Stepashka369/schemota/перечень элементов часть 1.pdf

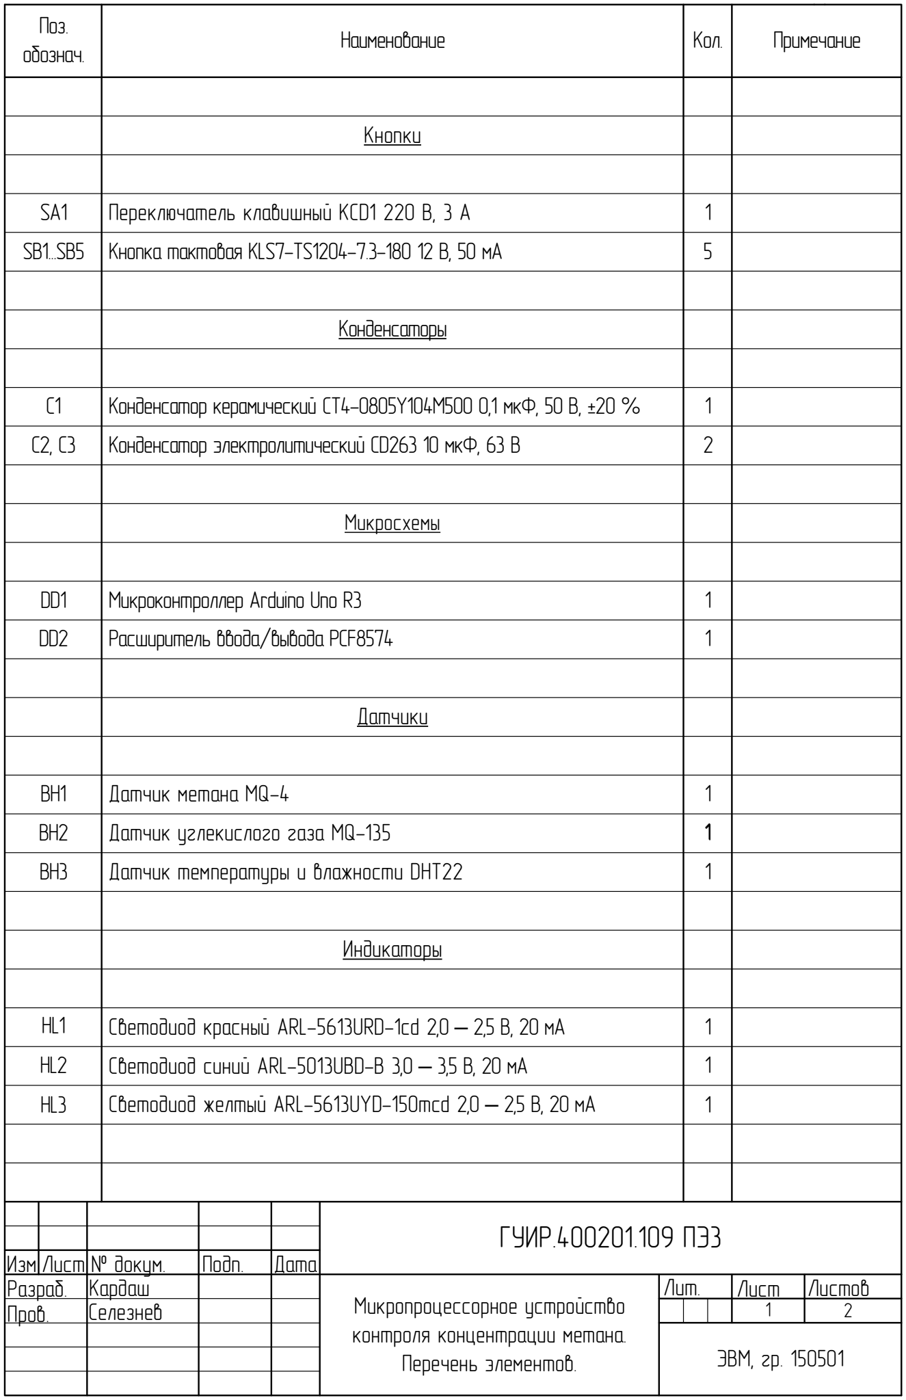
[picture p9: figure]
Изм Лист ¹ докум.; Подп.; Дата; Разраб.; Лит.; Лист; Листов; Пров.; Поз.; обознач.; Наименование; Кол.; Примечание; Микросхемы; Индикаторы; Кнопки; Конденсаторы; Переключатель клавишный KCD1 220 В, 3 А; Микроконтроллер Arduino Uno R3; Расширитель ввода/вывода PCF8574; Датчики; Датчик метана MQ-4; Датчик углекислого газа MQ-135; Датчик температуры и влажности DHT22; Кардаш Селезнев; ГУИР.400201.109 ПЭ3; ЭВМ, гр. 150501; Микропроцессорное устройство контроля концентрации метана. Перечень элементов.

Конденсатор керамический CT4-0805Y104M500 0,1 мкФ, 50 В, ±20 % Конденсатор электролитический CD263 10 мкФ, 63 В

Кнопка тактовая KLS7-TS1204-7.3-180 12 В, 50 мА

HL1 | Светодиод красный ARL-5613URD-1cd 2,0 – 2,5 В, 20 мА | 1
HL2 | Светодиод синий ARL-5013UBD-B 3,0 – 3,5 В, 20 мА | 1
HL3 | Светодиод желтый ARL-5613UYD-150mcd 2,0 – 2,5 В, 20 мА | 1
