Stepashka369/schemota/перечень элементов часть 2.pdf

Изм Лист | ¹ докум. | Подп. | Дата

Лист

Поз.
обознач. | Наименование | Кол. | Примечание

Устройство отображения информации

Резисторы

Приборы звуковой сигнализации

HA1 Пьезоэлемент активный YL-44

R1
R2

1
1

Резистор CF-25 20 Ком, 0.25 Вт ±5% Резистор CF-50 7.5 КОм 0.5 Вт ±5%

1

Жидкокристаллический дисплей LCD2004 | 1
ГУИР.400201.109 ПЭ3 | 2

R3
R4...R5
R6...R8 | 3
| 2
Резистор CF-100 3.3 Ком, 1 Вт ±5% | 1
Резистор CF-100 10 Ком, 1 Вт ±5%
Резистор CF-25 160 Ом, 0.25 Вт ±5%

HG1

Соединительные контакты

XS1 | Разъем CON-USBC | 1 | Гнездо USB Type-C

Реле

K1 | Реле электромагнитное TRC-5VDC-SC-AL-R 5 В | 1
XS2...XS3 | Разъем Dopont 1pin | 2 | Гнездо
