Stepashka369/schemota/структурная схема.pdf

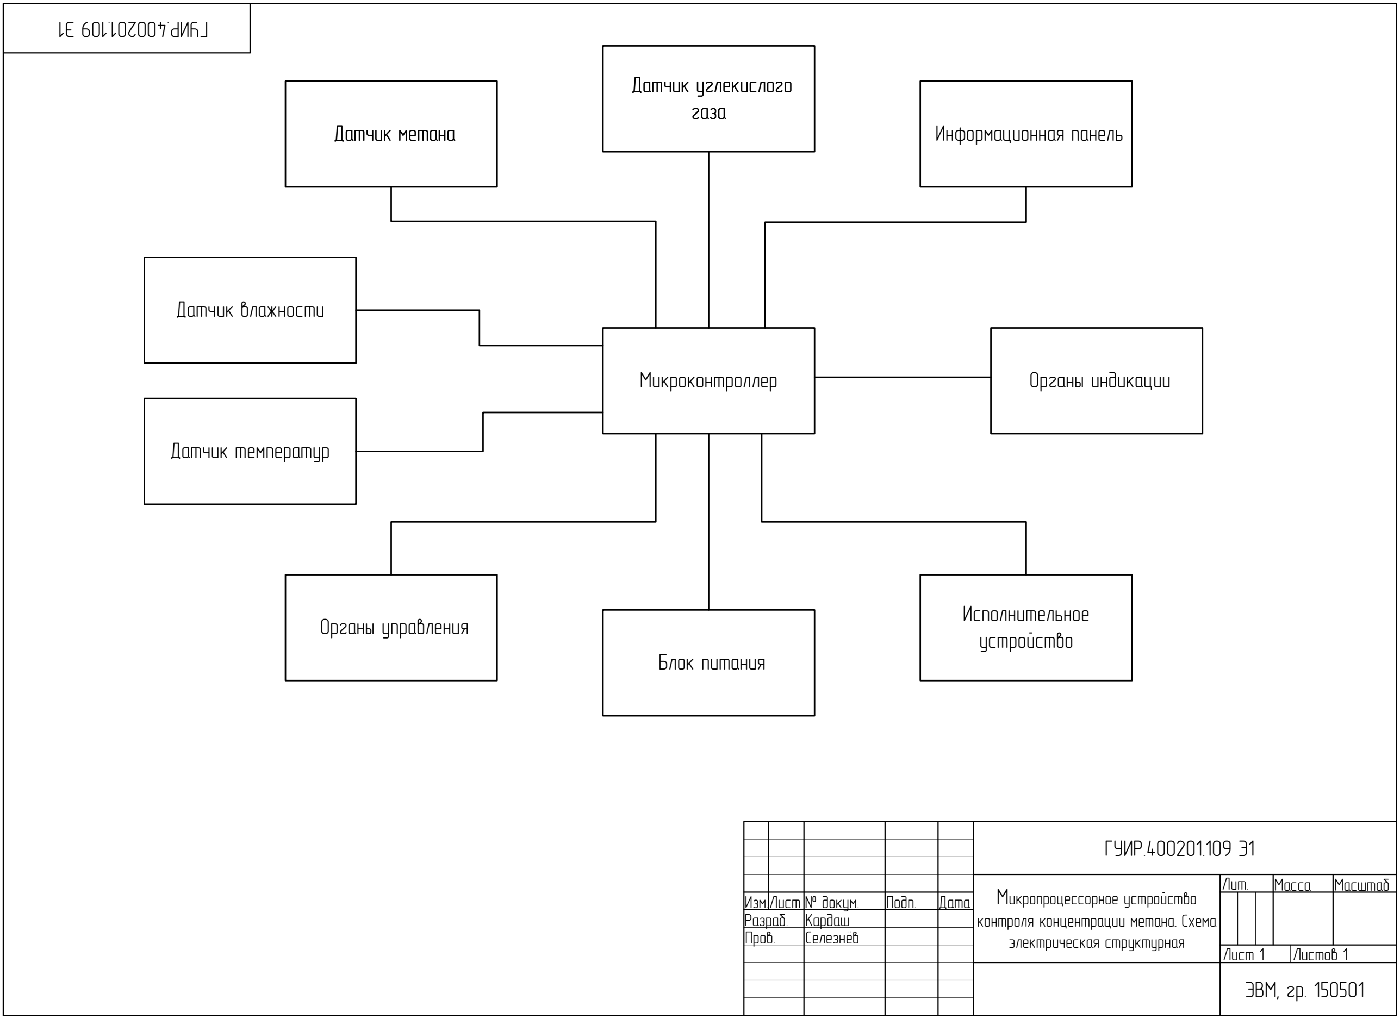
[picture p10: figure]
ГУИР.400201.109 Э1; Микропроцессорное устройство контроля концентрации метана. Схема электрическая структурная; Изм.Лист ¹ докум.; Подп.; Дата; Разраб. Пров.; Кардаш Селезнёв; Лит.; Масса; Масштаб; Лист 1; Листов 1; ЭВМ, гр. 150501; Датчик метана; Датчик углекислого газа; Датчик влажности; Органы индикации; Информационная панель; Органы управления; Исполнительное; устройство; Блок питания; Микроконтроллер; Датчик температур
