Stepashka369/schemota/(list of files, cad)

Other CAD files:
Ведомость документов.dwg
