Stepashka369/schemota/функциональная схема.pdf

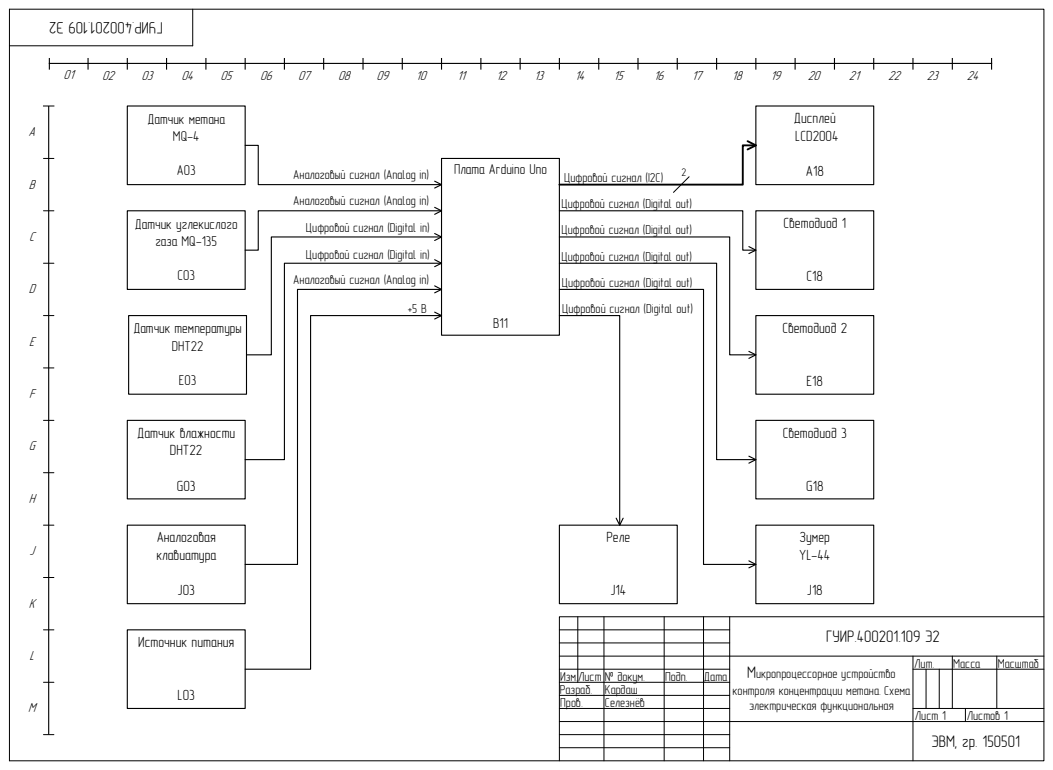
[picture p11: page 1]
ГУИР.400201.109 Э2; Изм.Лист ¹ докум.; Подп.; Дата; Разраб. Пров.; Кардаш Селезнёв; Лит.; Масса; Масштаб; Лист 1; Листов 1; ЭВМ, гр. 150501; Датчик метана MQ-4; Датчик углекислого газа MQ-135; Датчик температуры DHT22; Аналоговая клавиатура; Светодиод 1; Светодиод 2; Светодиод 3; Дисплей LCD2004; Источник питания; Датчик влажности DHT22; Цифровой сигнал (I2C); Зумер YL-44; Реле

Плата Arduino Uno

Аналоговый сигнал (Analog in)

Цифровой сигнал (Digital out)

Цифровой сигнал (Digital in)

Микропроцессорное устройство
контроля концентрации метана. Схема
электрическая функциональная
