Stepashka369/schemota/ведомость документов.pdf

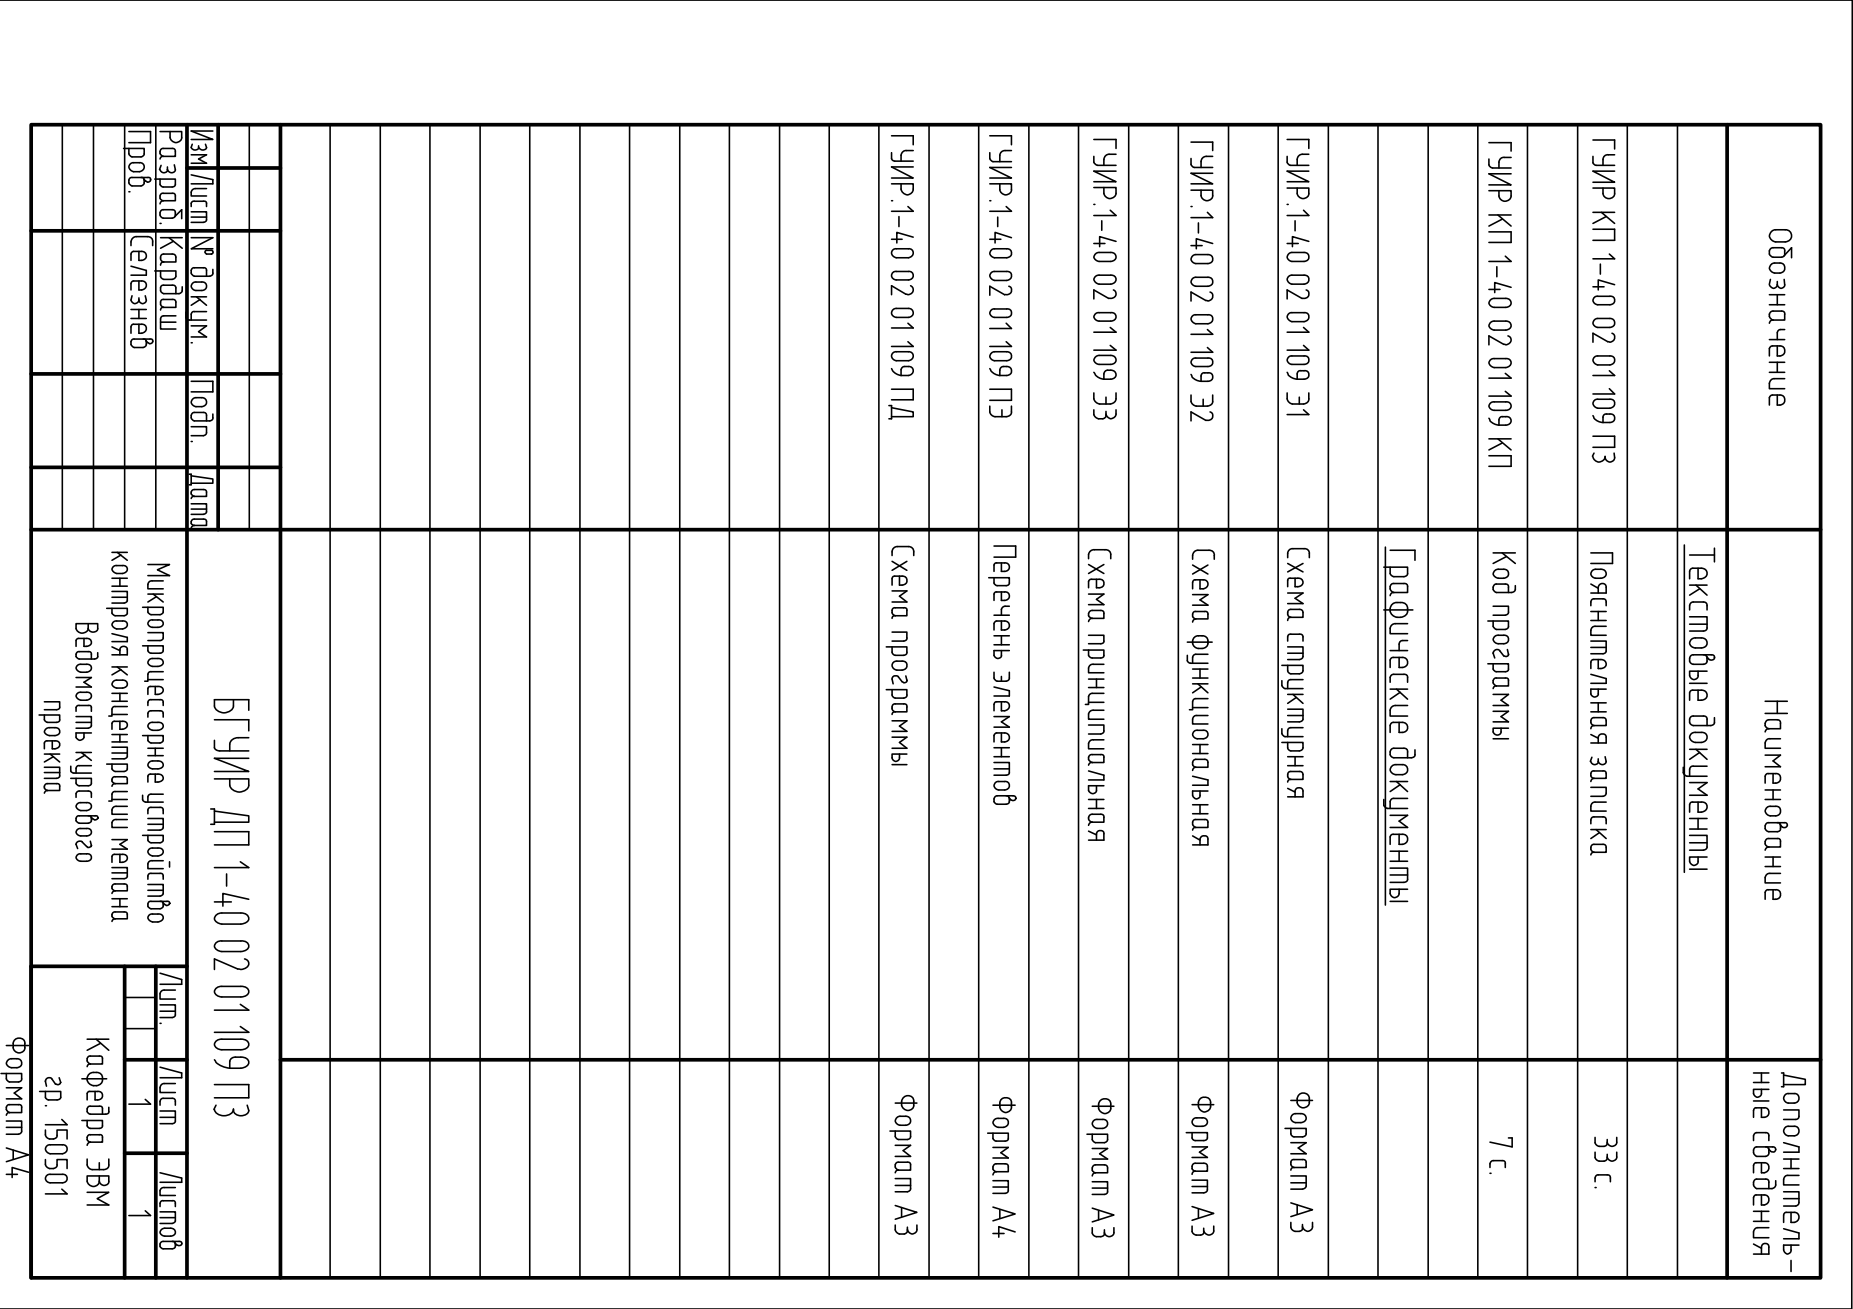
[picture p12: page 1]
