Stepashka369/schemota/принципиальная схема.pdf

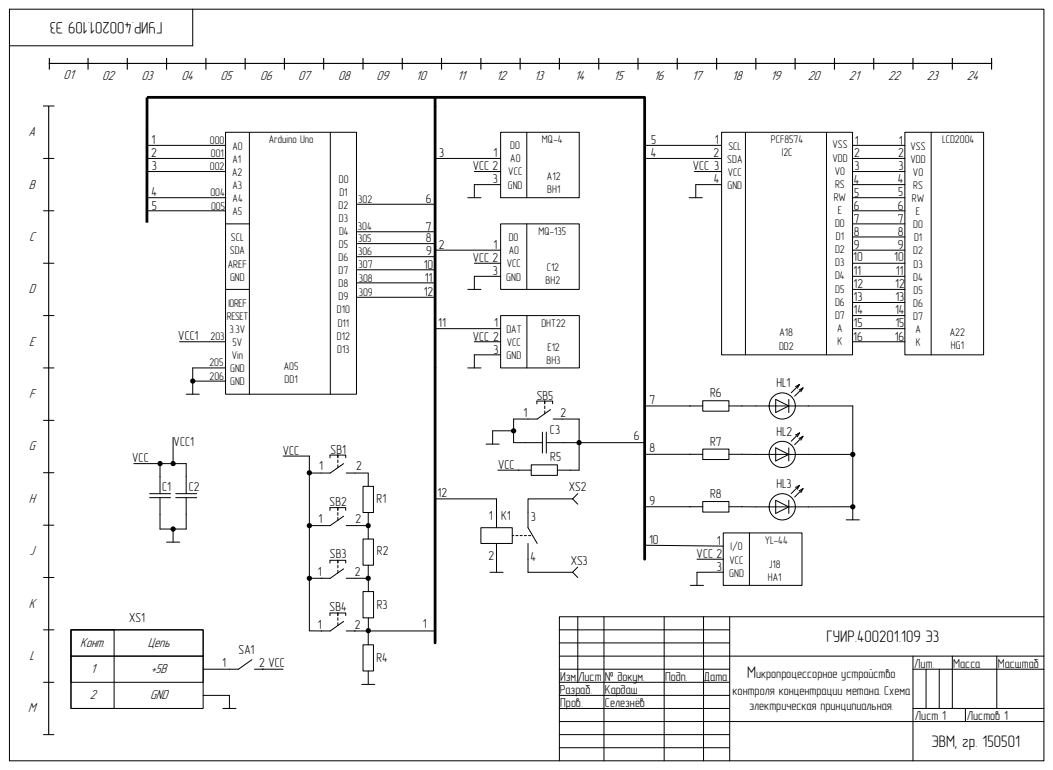
[picture p13: page 1]

Микропроцессорное устройство
контроля концентрации метана. Схема
электрическая принципиальная.
