Stepashka369/schemota/схема алгоритма.pdf

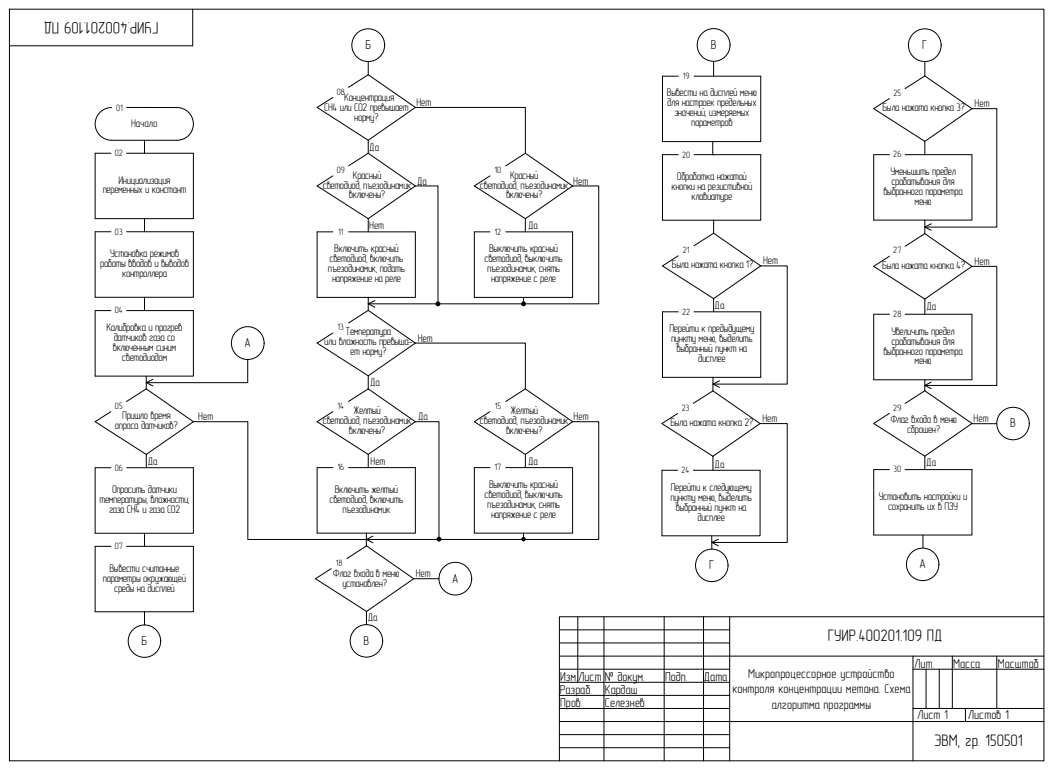
[picture p14: page 1]
ГУИР.400201.109 ПД; Изм.Лист ¹ докум.; Подп.; Дата; Разраб. Пров.; Кардаш Селезнев; Лит.; Масса; Масштаб; Лист 1; Листов 1; ЭВМ, гр. 150501; Инициализация переменных и констант; Начало; 05 Пришло время опроса датчиков?; Опросить датчики температуры, влажности, газа CH4 и газа CO2; 08 Концентрация CH4 или CO2 превышает норму?; Включить желтый светодиод, включить пъезодинамик; 14 Желтый светодиод, пъезодинамик включены?; 09 Красный светодиод, пъезодинамик включены?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

Вывести на дисплей меню
для настроек предельных
значений, измеряемых
параметров

Была нажата кнопка 3?

Обработка нажатой
кнопки на резистивной
клавиатуре

Установка режимов
работы вводов и выводов
контроллера

Включить красный
светодиод, включить
пъезодинамик, подать
напряжение на реле

Была нажата кнопка 1?

Была нажата кнопка 4?

Калибровка и прогрев
датчиков газа со
включенным синим
светодиодом

Перейти к предыдущему
пункту меню, выделить
выбранный пункт на
дисплее

13 Температура
или влажность превыша-
ет норму?

Была нажата кнопка 2?

Перейти к следующему

Установить настройки и
сохранить их в ПЗУ

Вывести считанные
параметры окружающей
среды на дисплей

Микропроцессорное устройство
контроля концентрации метана. Схема
алгоритма программы
