Stepashka369/schemota/(commit log)

2023-11-25 ready course work
    [Ведомость документов.dwg]
2023-11-28 correct some mistakes
    [Ведомость документов.dwg]
